AlishanHassan/Rain-Sensor-Prototyping/README.md

# Rain-Sensor-Prototyping
Prototyping the solid state rain sensor using a Particle.io Photon

### [Daily Log](https://github.com/AlishanHassan/Rain-Sensor-Prototyping/blob/master/Journal.md)
