AlishanHassan/Rain-Sensor-Prototyping/Photos/20160622_174756.jpg

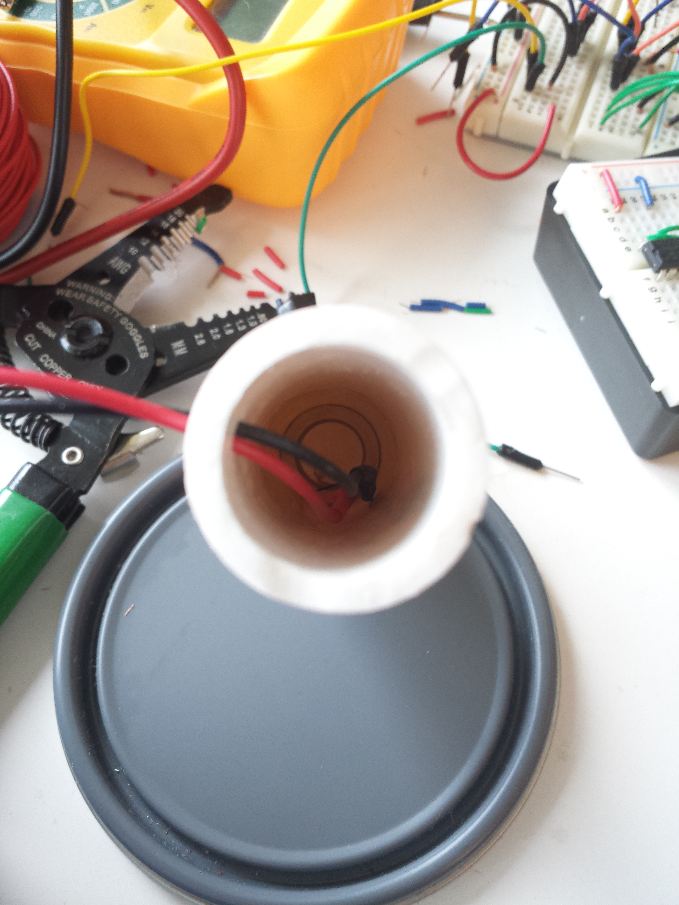
Photos/20160622_174756.jpg
