AlishanHassan/Rain-Sensor-Prototyping/Photos/20160623_180933.jpg

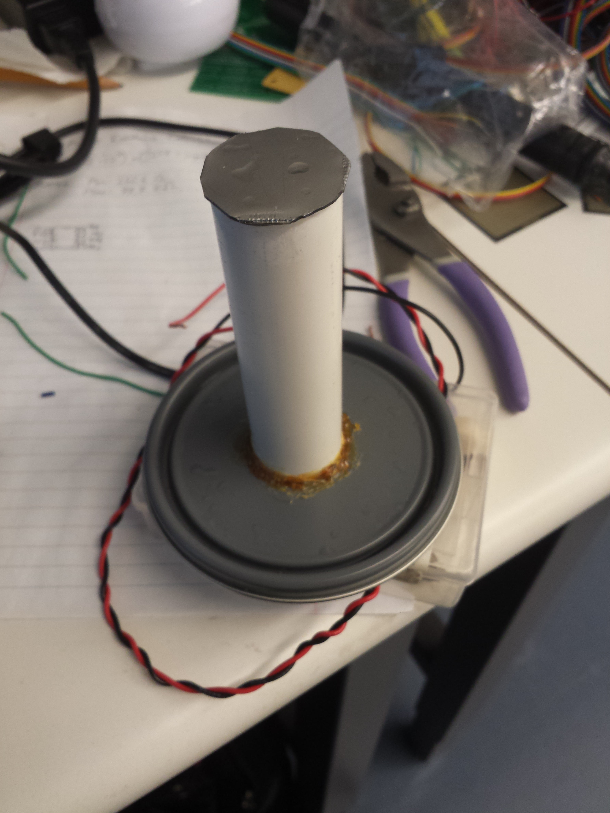
Photos/20160623_180933.jpg
