AlishanHassan/Rain-Sensor-Prototyping/Photos/20160623_191525.jpg

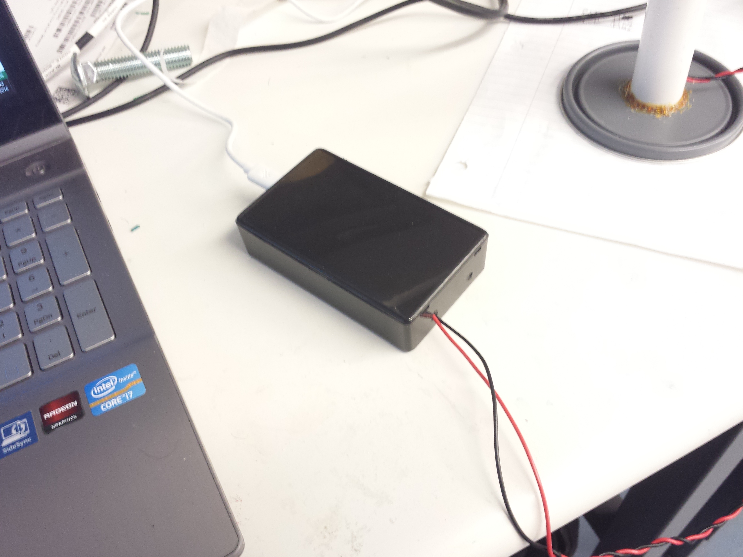
Photos/20160623_191525.jpg
