AlishanHassan/Rain-Sensor-Prototyping/Photos/20160623_192047.jpg

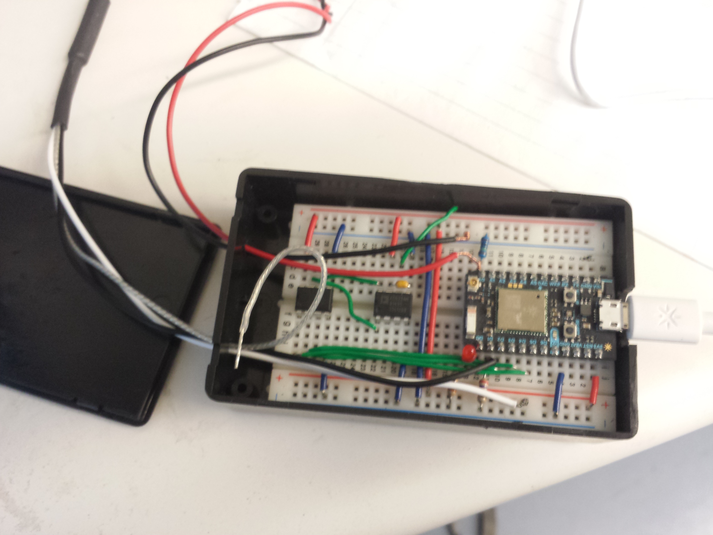
Photos/20160623_192047.jpg
