AlishanHassan/Rain-Sensor-Prototyping/Photos/20160623_192128.jpg

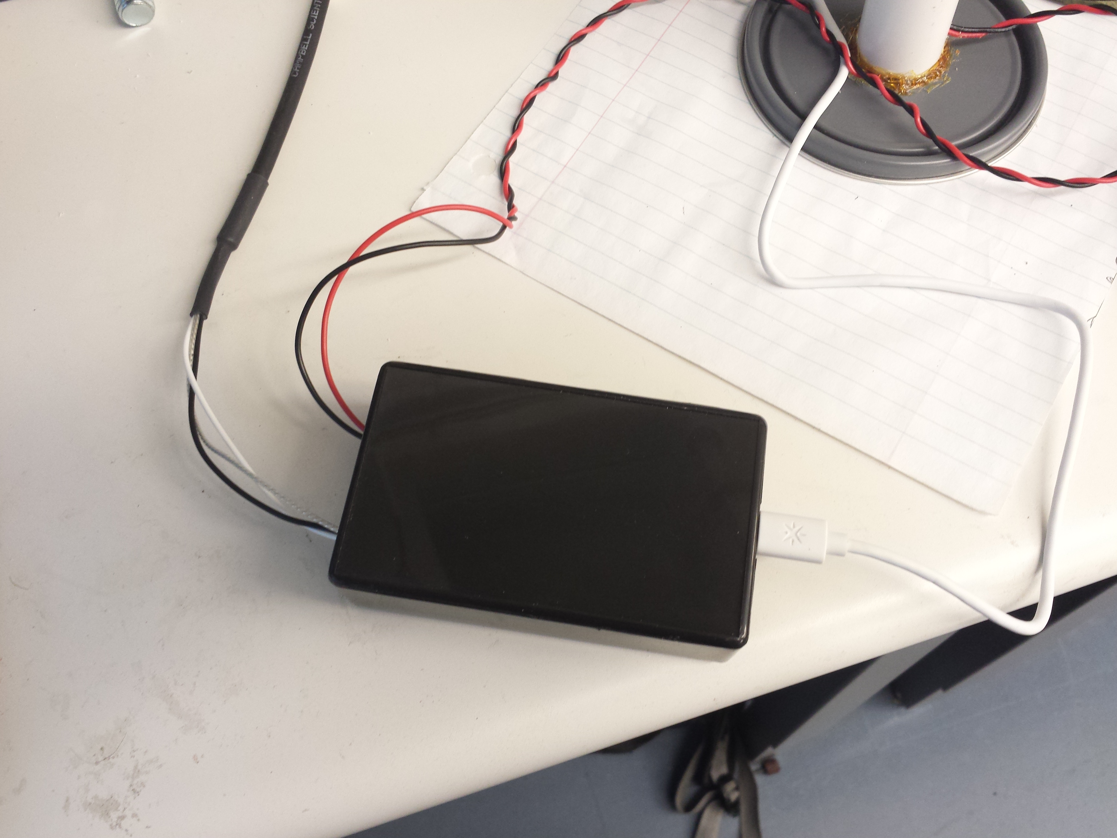
Photos/20160623_192128.jpg
