AlishanHassan/Rain-Sensor-Prototyping/Photos/20160625_152550.jpg

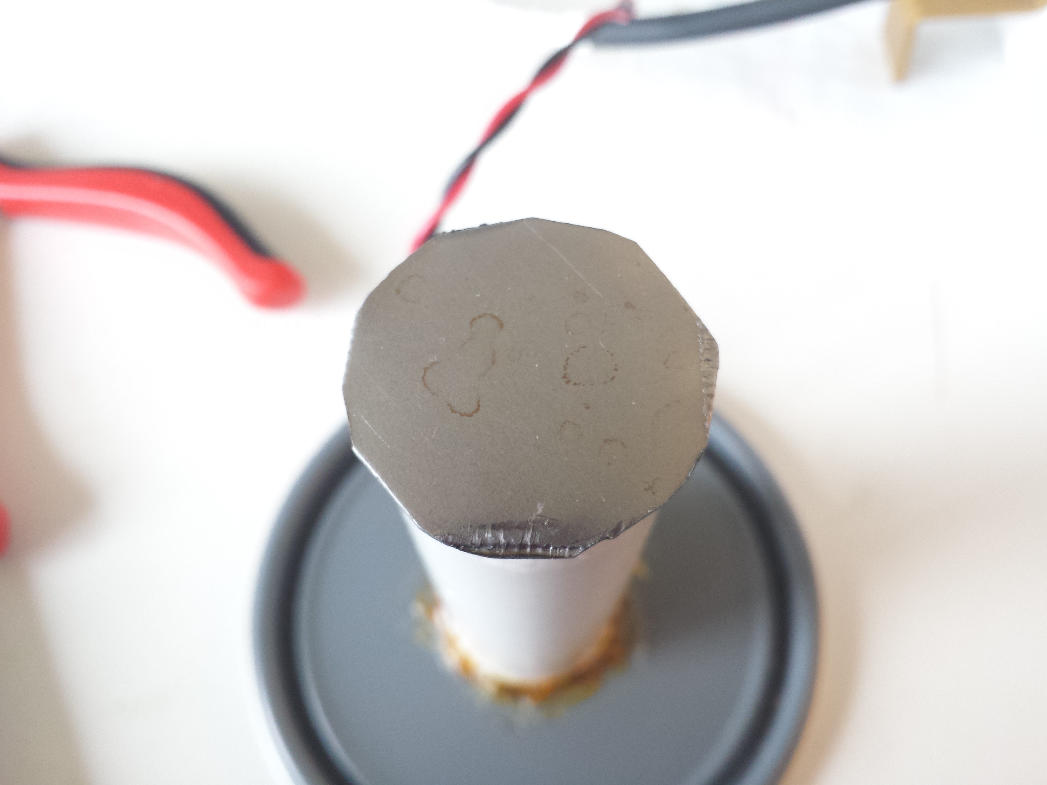
Photos/20160625_152550.jpg
