AlishanHassan/Rain-Sensor-Prototyping/Summer Progress Submission/Figures/piezodata.png

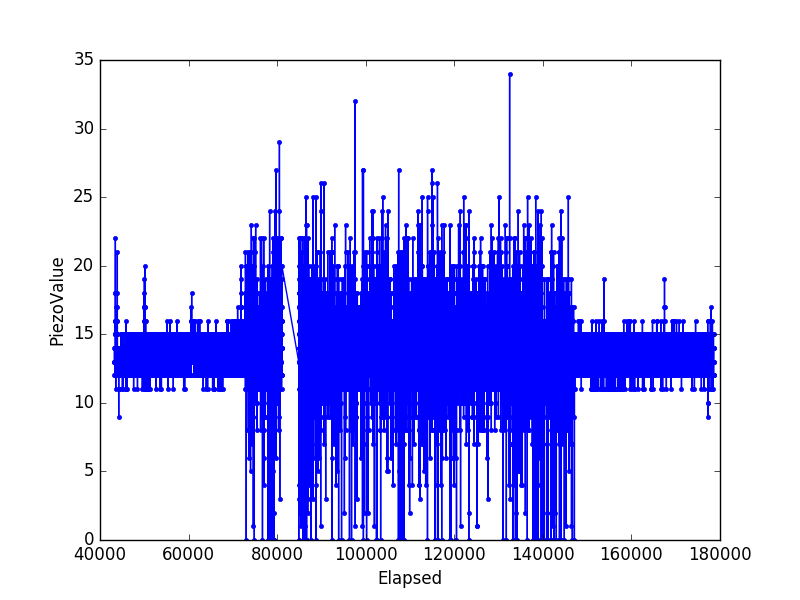
Summer Progress Submission/Figures/piezodata.png
