AlishanHassan/Rain-Sensor-Prototyping/Summer Progress Submission/Figures/withdegree10.png

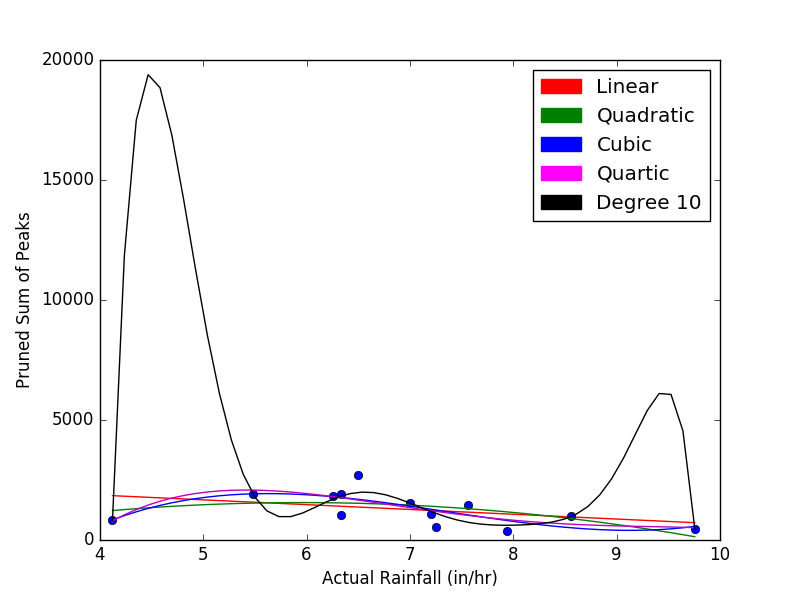
Summer Progress Submission/Figures/withdegree10.png
