AlishanHassan/Rain-Sensor-Prototyping/CAD/print steel plate holder structure.STL

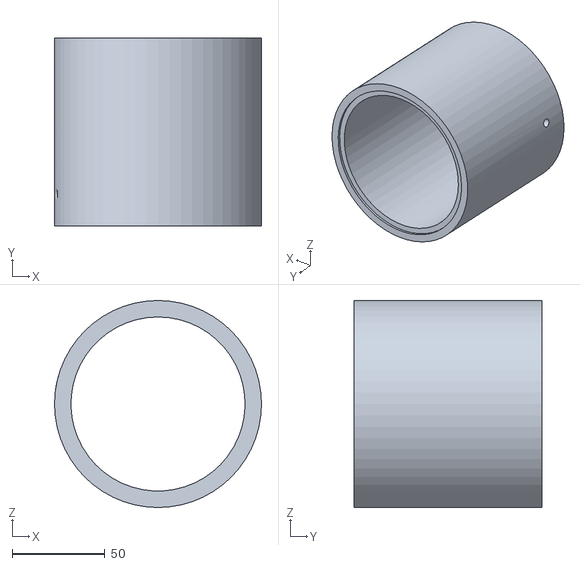
[picture p26: CAD file, 2016-05-27]
CAD/print steel plate holder structure.STL
111.8 x 101.6 x 111.8
