AlishanHassan/Rain-Sensor-Prototyping/(list of files, cad)

Other CAD files:
CAD/steel plate holder structure.SLDPRT
