AlishanHassan/Rain-Sensor-Prototyping/Serial Data Logger/data_20160623_170607 - no amp testing base acoustics.xlsx

DateTime | Elapsed | PiezoValue | BucketFlip | BucketCount
Mon Dec 1Thu Jun 23 21:06:15 2016 | 138626 | 14 | 0 | 0
Thu Jun 23 21:06:15 2016 | 138632 | 13 | 0 | 0
Thu Jun 23 21:06:15 2016 | 138638 | 13 | 0 | 0
Thu Jun 23 21:06:15 2016 | 138644 | 13 | 0 | 0
Thu Jun 23 21:06:15 2016 | 138650 | 13 | 0 | 0
Thu Jun 23 21:06:15 2016 | 138656 | 14 | 0 | 0
Thu Jun 23 21:06:15 2016 | 138662 | 10 | 0 | 0
Thu Jun 23 21:06:15 2016 | 138668 | 15 | 0 | 0
Thu Jun 23 21:06:15 2016 | 138674 | 13 | 0 | 0
Thu Jun 23 21:06:15 2016 | 138680 | 13 | 0 | 0
Thu Jun 23 21:06:15 2016 | 138686 | 14 | 0 | 0
Thu Jun 23 21:06:15 2016 | 138692 | 14 | 0 | 0
Thu Jun 23 21:06:15 2016 | 138698 | 12 | 0 | 0
Thu Jun 23 21:06:15 2016 | 138704 | 13 | 0 | 0
Thu Jun 23 21:06:15 2016 | 138710 | 14 | 0 | 0
Thu Jun 23 21:06:15 2016 | 138716 | 14 | 0 | 0
Thu Jun 23 21:06:15 2016 | 138722 | 14 | 0 | 0
Thu Jun 23 21:06:15 2016 | 138728 | 12 | 0 | 0
Thu Jun 23 21:06:15 2016 | 138734 | 14 | 0 | 0
Thu Jun 23 21:06:15 2016 | 138740 | 11 | 0 | 0
Thu Jun 23 21:06:15 2016 | 138746 | 12 | 0 | 0
Thu Jun 23 21:06:15 2016 | 138752 | 12 | 0 | 0
Thu Jun 23 21:06:15 2016 | 138758 | 15 | 0 | 0
Thu Jun 23 21:06:15 2016 | 138764 | 12 | 0 | 0
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
