AlishanHassan/Rain-Sensor-Prototyping/Serial Data Logger/data_20160720_194538 - tapping with possible amp fix removed.xlsx

DateTime | Elapsed | PiezoValue | BucketFlip | BucketCount
Wed Jul 20Wed Jul 20 23:45:41 2016 | 345968 | 20 | 0 | 0
Wed Jul 20 23:45:41 2016 | 345974 | 20 | 0 | 0
Wed Jul 20 23:45:41 2016 | 345980 | 19 | 0 | 0
Wed Jul 20 23:45:41 2016 | 345986 | 20 | 0 | 0
Wed Jul 20 23:45:41 2016 | 345992 | 20 | 0 | 0
Wed Jul 20 23:45:41 2016 | 345998 | 20 | 0 | 0
Wed Jul 20 23:45:41 2016 | 346004 | 20 | 0 | 0
Wed Jul 20 23:45:41 2016 | 346010 | 20 | 0 | 0
Wed Jul 20 23:45:41 2016 | 346016 | 20 | 0 | 0
Wed Jul 20 23:45:41 2016 | 346022 | 20 | 0 | 0
Wed Jul 20 23:45:41 2016 | 346028 | 20 | 0 | 0
Wed Jul 20 23:45:41 2016 | 346034 | 20 | 0 | 0
Wed Jul 20 23:45:41 2016 | 346040 | 21 | 0 | 0
Wed Jul 20 23:45:41 2016 | 346046 | 20 | 0 | 0
Wed Jul 20 23:45:41 2016 | 346052 | 20 | 0 | 0
Wed Jul 20 23:45:41 2016 | 346058 | 20 | 0 | 0
Wed Jul 20 23:45:41 2016 | 346064 | 20 | 0 | 0
Wed Jul 20 23:45:41 2016 | 346070 | 20 | 0 | 0
Wed Jul 20 23:45:41 2016 | 346076 | 20 | 0 | 0
Wed Jul 20 23:45:41 2016 | 346082 | 20 | 0 | 0
Wed Jul 20 23:45:41 2016 | 346088 | 21 | 0 | 0
Wed Jul 20 23:45:41 2016 | 346094 | 20 | 0 | 0
Wed Jul 20 23:45:41 2016 | 346100 | 20 | 0 | 0
Wed Jul 20 23:45:41 2016 | 346106 | 20 | 0 | 0
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
