AlishanHassan/Rain-Sensor-Prototyping/(commit log)

2016-03-02 Rearrange files and add CAD file
    [steel plate holder structure.SLDPRT]
2016-05-27 Leftover CAD part
    [print steel plate holder structure.STL]
2016-05-31 Few logger tweakers and some test data
    [data_20160531_192220.xlsx, data_20160531_193834.xlsx]
2016-06-07 Trying to get SPI to work
2016-06-07 SPI test code that works
2016-06-10 Some more logged data and misc. files
    [data_20160609_155353 - disk.xlsx, data_20160609_155600 - film.xlsx, data_20160610_162938 - flat cap not attached.xlsx, data_20160610_163737 - flat cap not attached one tap.xlsx]
2016-06-22 Test data with superglued sensor and cap
    [data_20160621_195310 - superglued flat cap and piezo.xlsx, data_20160621_195809 - superglued two taps.xlsx]
2016-06-22 Some new data with the new breadboard.
    [data_20160622_190834 - new breadboard mega amp.xlsx, data_20160622_191436 - 0 ms delay no amp.xlsx, data_20160622_192210 - 5 ms delay again no amp.xlsx, data_20160622_192513 - 0 ms delay no amp.xlsx]
2016-06-23 Amplifier is being weird again...
    [data_20160622_195803.xlsx]
2016-06-23 Nearly ready for the rain
    [data_20160623_163157 - amped with pot at 0xF0.xlsx, data_20160623_163630 - amped with pot at 0xFF.xlsx, data_20160623_163912 - amped with pot at 0xFF 5ms delay one dropped item.xlsx, data_20160623_164112 - amped with pot at 0xFF 5ms delay and a bunch of taps.xlsx, data_20160623_165527 - no amp 5ms delay bunch of taps.xlsx, data_20160623_165906 - new amp with pot at 0xFF 5ms delay and a bunch of t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]
2016-06-24 Doing a rain dance
    [data_20160623_190807 - in the project box.xlsx, data_20160623_192305 - black box with tipping bucket too.xlsx]
2016-06-27 Sprinker time
    [data_20160626_182435 - sprinkler time.xlsx, data_20160626_184614 - sprinkler rain.xlsx]
2016-06-27 It's actually raining
    [data_20160627_180025 - raining continued after computer fell asleep.xlsx]
2016-06-29 Some new data
    [data_20160629_153027 - towel drops amped at 0x20.xlsx, data_20160629_153652 - light tapping amped at 0x20.xlsx, data_20160629_154140 - dropped small item amped at 0x20.xlsx, data_20160629_154649 - dropped small item no amp.xlsx, data_20160629_154858 - towel drops no amp.xlsx]
2016-07-04 Dual supply hack job
    [data_20160703_201006 - dual rail hack job taps.xlsx, data_20160703_201245 - dual rail hack job eye dropper.xlsx]
2016-07-04 Acoustic pitch and brightness
2016-07-13 Excel keeps crashing, need a backup
    [data_20160626_184614 - sprinkler rain.xlsx]
2016-07-18 Excel crashing again, so making backup...
    [Loop 2.xlsm, data_20160715_202748 - outside with rain machine no amp flat steel cap low pressure low height.xlsx, data_20160715_203559 - outside with rain machine no amp flat steel cap high pressure med height.xlsx, data_20160715_204030 - outside with rain machine no amp flat steel cap high pressure high height.xlsx]
2016-07-21 Lotsa stuff, I'm being lazy with ze pushing
    [Loop 2.xlsm, Loop 3.xlsm, Loop 4.xlsm, Loop 5.xlsm, data_20160720_164733.xlsx, data_20160720_164755 -outside with rain machine with diode no amp flat steel cap high pressure high height.xlsx, data_20160720_173826 - outside with rain machine with diode no amp flat steel cap high pressure high height.xlsx, data_20160720_194101 - tapping with possibly fixed amp.xlsx]
2016-11-05 Windows 10 is a vile abomination that needs to be expunged on systems everywhere.
    [Loop 6.xlsm, data_20160722_201032 - outside with rain machine cone nozzle no diode no amp flat steel cap high pressure highish height.xlsx, data_20160722_201555 - outside with rain machine shower nozzle no diode no amp flat steel cap high pressure highish height.xlsx, data_20160725_182512 - outside with rain machine shower nozzle no diode no amp flat steel cap high pressure high height.xlsx, data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]
